dkwolf1/Brink-PCB/hardware/rev-2026-10-11/onderdelenlijst.tsv

ID | Name | Designator | Footprint | Quantity | Manufacturer Part | Manufacturer | Supplier | Supplier Part | Pins
1 | TestPoint_Red | RX,TX,3.3V,GND,VCC | TEST_TESTPOINT | 5 |  |  |  |  | 1
2 | 4.7k | R1,R7 | R1206 | 2 |  |  |  |  | 2
3 | 680 | R4 | R1206 | 1 |  |  |  |  | 2
4 | 1k | R5,R6,R10 | R1206 | 3 |  |  |  |  | 2
5 | 10 | R11 | R1206 | 1 |  |  |  |  | 2
6 | 0.1u | C7,C8,C5,C1 | C1206 | 4 |  |  |  |  | 2
7 | 100k | R12,R13 | R1206 | 2 |  |  |  |  | 2
8 | 100nf | C14,C11,C13 | C1206 | 3 |  |  |  |  | 2
9 | 10k | R15,R18,R14,R2,R8,R9,R3 | R1206 | 7 |  |  |  |  | 2
10 | 47k | R19 | R1206 | 1 |  |  |  |  | 2
11 | KT-1206Red LED | LED5,LED2 | LED1206-R-RD_RED | 2 | KT-1206R | KENTO | LCSC | C49018 | 2
12 | 10uf | C10 | CAP-D8.0×H10.5 | 1 |  |  |  |  | 2
13 | 22uf | C12 | CAP-D8.0×H10.5 | 1 |  |  |  |  | 2
14 | 24v | J10,J7 | HDR-M-2.54_1X3 | 2 |  |  | LCSC | C180248 | 3
15 | 1N4148 | D4,D5 | DO-41 | 2 |  |  |  |  | 2
16 | Switch3x4x2 | KEY1,KEY2 | SW-SMD_L4.0-W2.9-LS5.0 | 2 | 轻触开关3x4x2 | 国产 | LCSC | C26638 | 2
17 | 2.2k | R16,R17 | R1206 | 2 |  |  |  |  | 2
18 | AMS1117-3.3(SOT-223) | U7 | SOT-223-3_L6.7-W3.7-P2.30-LS7.0-BR | 1 | AMS1117-3.3(SOT-223) | HXY MOSFET(华轩阳电子) | LCSC | C5346136 | 4
19 | AO3401 | Q4 | SOT-23-3_L2.9-W1.6-P1.90-LS2.8-BR | 1 | AO3401 | TWGMC | LCSC | C727156 | 3
20 | 2A polyfuse | U5 | F1206 | 1 | PPTCSMD1A30V-1206 | null | LCSC | C9900007431 | 2
21 | 100UF/35V-6.3X7.7SMD | C9,C2,C6 | CAP-SMD_BD6.3-L6.6-W6.6-FD | 3 | 100uF/35V-6.3X7.7SMD | null | LCSC | C9900004345 | 2
22 | HDR-M-2.54_1x2 | J9,J3,J4,J5 | HDR-M-2.54_1X2 | 4 |  |  | LCSC | C124375 | 2
23 | MMBT2222A_C171740 | Q3 | SOT-23-3_L2.9-W1.3-P1.90-LS2.4-BR | 1 | MMBT2222A | SHIKUES(时科) | LCSC | C171740 | 3
24 | LBC858BLTJ | Q1,Q2 | SOT-23-3_L2.9-W1.3-P1.90-LS2.4-BR | 2 | LBC858CLT1G | LRC(乐山无线电) | LCSC | C5273108 | 3
25 | 500ah | U4 | F1206 | 1 | PPTCSMD1A30V-1206 | null | LCSC | C9900007431 | 2
26 | 1000ah | U6 | F1206 | 1 | PPTCSMD1A30V-1206 | null | LCSC | C9900007431 | 2
27 | HDR-M-2.54_1x1 | J8 | HDR-M-2.54_1X1 | 1 |  |  | LCSC | C81276 | 1
28 | M2-MOUNTING-HOLE | MH1,MH2,MH3,MH4 | M2-MOUNTING-HOLE | 4 |  |  |  |  | 1
29 | 470uf | C4 | CAP-D8.0×H10.5 | 1 |  |  |  |  | 2
30 | 0.1uf | C3 | C1206 | 1 |  |  |  |  | 2
31 | E beneden | CN1 | RJ12-TH_95501-2661 | 1 | 95501-2661 | MOLEX | LCSC | C240856 | 6
32 | E boven | CN2 | RJ12-TH_95501-2661 | 1 | 95501-2661 | MOLEX | LCSC | C240856 | 6
33 | WTW | CN3 | RJ12-TH_95501-2661 | 1 | 95501-2661 | MOLEX | LCSC | C240856 | 6
34 | 1N5819 | D1 | 1N5819 | 1 | UF4007 | STARSEA |  | C84067 | 2
35 | DC005-2.0MM | DC1 | DC-IN-TH_DC005 | 1 | DC005-2.0MM | SOFNG | LCSC | C111567 | 3
36 | HDR-F-2.54_1x2 | H1,H2,H3,H4,H5,H6,H7,H8,H10 | HDR-F-2.54_1X2 | 9 |  |  | LCSC | C49661 | 2
37 | HDR-M-2.54_1x3 | J1 | HDR-M-2.54_1X3 | 1 |  |  | LCSC | C180248 | 3
38 | LED-TH-3mm_G | LED1 | LED-TH_BD3.0_GREEN | 1 | 204-10SYGD/S530-E3 | EVERLIGHT(台湾亿光) |  | C85161 | 2
39 | LED-TH-3mm_R | LED3 | LED-TH_BD3.0_RED | 1 | 204-10SDRD/S530-A3-L | EVERLIGHT(台湾亿光) | LCSC | C84774 | 2
40 | LED-TH-3mm_B | LED4 | LED-TH_BD3.0_BLUE | 1 | 204-10SUBC/S400-A4 | EVERLIGHT(台湾亿光) | LCSC | C86881 | 2
41 | PC817 | OP1,OP2 | PC817 | 2 |  |  |  |  | 4
42 | ESP32 DevKitC V4 ESP32-WROOM-32U | U1 | ESP32DEVKITCV4 | 1 | ESP32 Dev Kit C V4 | AZ-DELIVERY |  |  | 38
43 | 8-Channel_Relay_Module | U2 | 8CH-RELAY-MODULE-PINBATCH3 | 1 | 8-Channel 5V Relay Module |  |  | SKU: 223429 | 10
44 | Relay Module 5V 10A 240AC | U3 | MOD-RELAY-5V-10A | 1 |  | OEM | GRobotronics | 19-00010724
45 | HDR-M-2.54_1x4 | J6 | HDR-M-2.54_1X4 | 1 |  |  | LCSC | C124378 | 4
46 | HDR-M-2.54_1x10 | J2 | HDR-M-2.54_1X10 | 1 |  |  | LCSC | C57369 | 10
