dkwolf1/Brink-PCB/hardware/rev-2026-10-11/schema.pdf

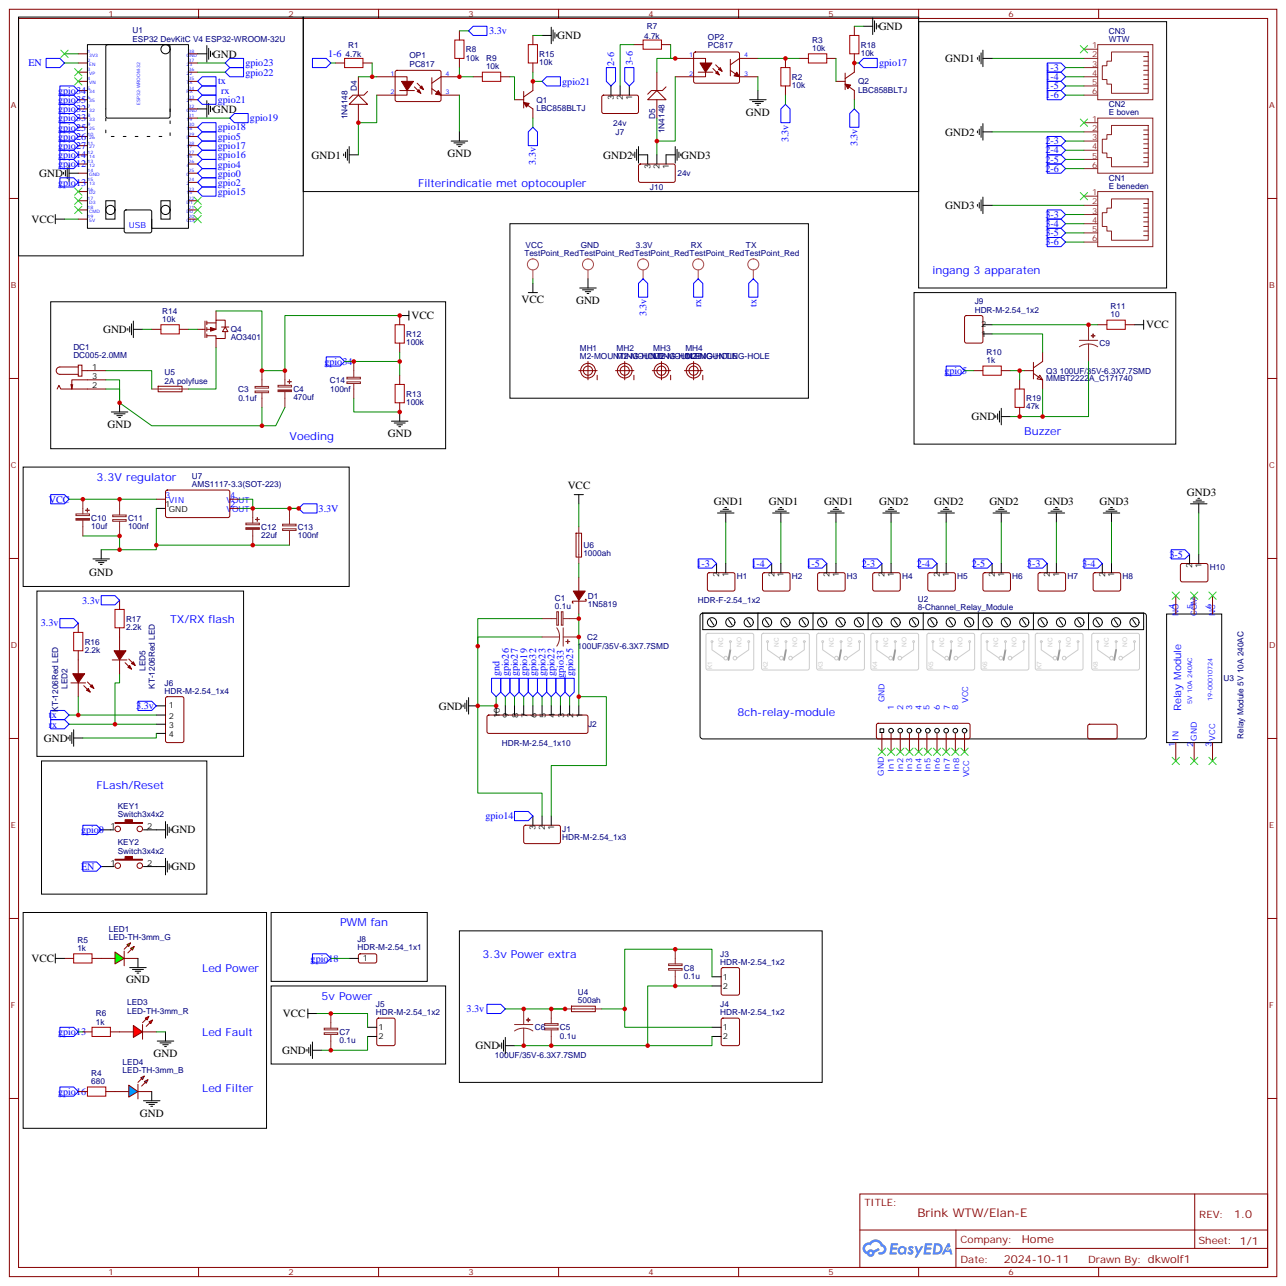
[picture p34: page 1]
