dkwolf1/Brink-PCB/(commit log)

2026-10-11 Document PCB revision and ESPHome example
2026-10-11 Add bilingual documentation and PCB revision files
2026-10-11 Add bilingual documentation, PCB files and MIT license
